JoshAshby/Robotbob/Doc/dox/latex/uart_8h.tex

\hypertarget{uart_8h}{
\section{/home/joshua/Desktop/Stuff/github/repos/Robotbob/uart.h File Reference}
\label{uart_8h}\index{/home/joshua/Desktop/Stuff/github/repos/Robotbob/uart.h@{/home/joshua/Desktop/Stuff/github/repos/Robotbob/uart.h}}
}
{\ttfamily \#include \char`\"{}global.h\char`\"{}}\par
\subsection*{Defines}
\begin{DoxyCompactItemize}
\item 
\#define \hyperlink{uart_8h_a62634036639f88eece6fbf226b45f84b}{BAUD}~9600
\item 
\#define \hyperlink{uart_8h_a6ac7d11a56af31a55035980e2fed464a}{BUFF\_\-LEN}~700
\item 
\#define \hyperlink{uart_8h_aa6b92cd101806fab27f766552beac344}{BAUD\_\-PRESCALE}~(((F\_\-CPU / (BAUD $\ast$ 16UL))) -\/ 1)
\end{DoxyCompactItemize}
\subsection*{Functions}
\begin{DoxyCompactItemize}
\item 
void \hyperlink{uart_8h_a57dec283060c68725e979681a6bda710}{uart\_\-start} (void)
\begin{DoxyCompactList}\small\item\em Sets up the registers and starts the UART for a baud of 9600. \item\end{DoxyCompactList}\item 
void \hyperlink{uart_8h_a3aa33581e04c3d77bf6baf4453699c60}{uart\_\-sendint} (uint8\_\-t data)
\begin{DoxyCompactList}\small\item\em Send an 8bit long piece of data. \item\end{DoxyCompactList}\item 
void \hyperlink{uart_8h_a5f6766b9959ff631558c8c6314c48551}{uart\_\-sendint16} (uint16\_\-t data)
\begin{DoxyCompactList}\small\item\em Send a 16bit long piece of data. \item\end{DoxyCompactList}\item 
void \hyperlink{uart_8h_a23796b5110daf59f60bf0e24073723e5}{uart\_\-sendchar} (char $\ast$data)
\begin{DoxyCompactList}\small\item\em Sends either a single piece of data stored as a char, or sends a string. (If sending a string, avr-\/gcc will yell a warning at you, you can ignore it). \item\end{DoxyCompactList}\item 
uint8\_\-t \hyperlink{uart_8h_a26112ddd1ecbbf65d98511a3434bc8d5}{uart\_\-get} (void)
\begin{DoxyCompactList}\small\item\em Returns the data which was stored in the recieve register and retreived by the interrupt. \item\end{DoxyCompactList}\end{DoxyCompactItemize}
\subsection*{Variables}
\begin{DoxyCompactItemize}
\item 
char \hyperlink{uart_8h_ab081191b17e7bd10a1479ae8aa05e879}{input\_\-buffer} \mbox{[}BUFF\_\-LEN\mbox{]}
\item 
uint16\_\-t \hyperlink{uart_8h_a15495a67f4607849736feca6c3f11b08}{read\_\-spot}
\end{DoxyCompactItemize}

\subsection{Define Documentation}
\hypertarget{uart_8h_a62634036639f88eece6fbf226b45f84b}{
\index{uart.h@{uart.h}!BAUD@{BAUD}}
\index{BAUD@{BAUD}!uart.h@{uart.h}}
\subsubsection[{BAUD}]{\setlength{\rightskip}{0pt plus 5cm}\#define BAUD~9600}}
\label{uart_8h_a62634036639f88eece6fbf226b45f84b}
\hypertarget{uart_8h_aa6b92cd101806fab27f766552beac344}{
\index{uart.h@{uart.h}!BAUD\_\-PRESCALE@{BAUD\_\-PRESCALE}}
\index{BAUD\_\-PRESCALE@{BAUD\_\-PRESCALE}!uart.h@{uart.h}}
\subsubsection[{BAUD\_\-PRESCALE}]{\setlength{\rightskip}{0pt plus 5cm}\#define BAUD\_\-PRESCALE~(((F\_\-CPU / (BAUD $\ast$ 16UL))) -\/ 1)}}
\label{uart_8h_aa6b92cd101806fab27f766552beac344}
\hypertarget{uart_8h_a6ac7d11a56af31a55035980e2fed464a}{
\index{uart.h@{uart.h}!BUFF\_\-LEN@{BUFF\_\-LEN}}
\index{BUFF\_\-LEN@{BUFF\_\-LEN}!uart.h@{uart.h}}
\subsubsection[{BUFF\_\-LEN}]{\setlength{\rightskip}{0pt plus 5cm}\#define BUFF\_\-LEN~700}}
\label{uart_8h_a6ac7d11a56af31a55035980e2fed464a}

\subsection{Function Documentation}
\hypertarget{uart_8h_a26112ddd1ecbbf65d98511a3434bc8d5}{
\index{uart.h@{uart.h}!uart\_\-get@{uart\_\-get}}
\index{uart\_\-get@{uart\_\-get}!uart.h@{uart.h}}
\subsubsection[{uart\_\-get}]{\setlength{\rightskip}{0pt plus 5cm}uint8\_\-t uart\_\-get (
\begin{DoxyParamCaption}
\item[{void}]{}
\end{DoxyParamCaption}
)}}
\label{uart_8h_a26112ddd1ecbbf65d98511a3434bc8d5}

Returns the data which was stored in the recieve register and retreived by the interrupt. 

\begin{DoxyParams}{Parameters}
\item[{\em void}]-\/ Takes nothing \end{DoxyParams}
\begin{DoxyReturn}{Returns}
uint8\_\-t -\/ The data in the form of an 8bit long piece of data 
\end{DoxyReturn}
\hypertarget{uart_8h_a23796b5110daf59f60bf0e24073723e5}{
\index{uart.h@{uart.h}!uart\_\-sendchar@{uart\_\-sendchar}}
\index{uart\_\-sendchar@{uart\_\-sendchar}!uart.h@{uart.h}}
\subsubsection[{uart\_\-sendchar}]{\setlength{\rightskip}{0pt plus 5cm}void uart\_\-sendchar (
\begin{DoxyParamCaption}
\item[{char $\ast$}]{ data}
\end{DoxyParamCaption}
)}}
\label{uart_8h_a23796b5110daf59f60bf0e24073723e5}

Sends either a single piece of data stored as a char, or sends a string. (If sending a string, avr-\/gcc will yell a warning at you, you can ignore it). 

\begin{DoxyParams}{Parameters}
\item[{\em data}]char$\ast$ -\/ The char data, or a string \end{DoxyParams}
\begin{DoxyReturn}{Returns}
void -\/ Returns nothing 
\end{DoxyReturn}
\hypertarget{uart_8h_a3aa33581e04c3d77bf6baf4453699c60}{
\index{uart.h@{uart.h}!uart\_\-sendint@{uart\_\-sendint}}
\index{uart\_\-sendint@{uart\_\-sendint}!uart.h@{uart.h}}
\subsubsection[{uart\_\-sendint}]{\setlength{\rightskip}{0pt plus 5cm}void uart\_\-sendint (
\begin{DoxyParamCaption}
\item[{uint8\_\-t}]{ data}
\end{DoxyParamCaption}
)}}
\label{uart_8h_a3aa33581e04c3d77bf6baf4453699c60}

Send an 8bit long piece of data. 

\begin{DoxyParams}{Parameters}
\item[{\em data}]uint8\_\-t -\/ The 8bit long data \end{DoxyParams}
\begin{DoxyReturn}{Returns}
void -\/ Returns nothing 
\end{DoxyReturn}
\hypertarget{uart_8h_a5f6766b9959ff631558c8c6314c48551}{
\index{uart.h@{uart.h}!uart\_\-sendint16@{uart\_\-sendint16}}
\index{uart\_\-sendint16@{uart\_\-sendint16}!uart.h@{uart.h}}
\subsubsection[{uart\_\-sendint16}]{\setlength{\rightskip}{0pt plus 5cm}void uart\_\-sendint16 (
\begin{DoxyParamCaption}
\item[{uint16\_\-t}]{ data}
\end{DoxyParamCaption}
)}}
\label{uart_8h_a5f6766b9959ff631558c8c6314c48551}

Send a 16bit long piece of data. 

\begin{DoxyParams}{Parameters}
\item[{\em data}]uint16\_\-t -\/ The 16bit long data \end{DoxyParams}
\begin{DoxyReturn}{Returns}
void -\/ Returns nothing 
\end{DoxyReturn}
\hypertarget{uart_8h_a57dec283060c68725e979681a6bda710}{
\index{uart.h@{uart.h}!uart\_\-start@{uart\_\-start}}
\index{uart\_\-start@{uart\_\-start}!uart.h@{uart.h}}
\subsubsection[{uart\_\-start}]{\setlength{\rightskip}{0pt plus 5cm}void uart\_\-start (
\begin{DoxyParamCaption}
\item[{void}]{}
\end{DoxyParamCaption}
)}}
\label{uart_8h_a57dec283060c68725e979681a6bda710}

Sets up the registers and starts the UART for a baud of 9600. 

\begin{DoxyParams}{Parameters}
\item[{\em void}]-\/ Takes nothing \end{DoxyParams}
\begin{DoxyReturn}{Returns}
void -\/ Returns nothing 
\end{DoxyReturn}

\subsection{Variable Documentation}
\hypertarget{uart_8h_ab081191b17e7bd10a1479ae8aa05e879}{
\index{uart.h@{uart.h}!input\_\-buffer@{input\_\-buffer}}
\index{input\_\-buffer@{input\_\-buffer}!uart.h@{uart.h}}
\subsubsection[{input\_\-buffer}]{\setlength{\rightskip}{0pt plus 5cm}char {\bf input\_\-buffer}\mbox{[}BUFF\_\-LEN\mbox{]}}}
\label{uart_8h_ab081191b17e7bd10a1479ae8aa05e879}
\hypertarget{uart_8h_a15495a67f4607849736feca6c3f11b08}{
\index{uart.h@{uart.h}!read\_\-spot@{read\_\-spot}}
\index{read\_\-spot@{read\_\-spot}!uart.h@{uart.h}}
\subsubsection[{read\_\-spot}]{\setlength{\rightskip}{0pt plus 5cm}uint16\_\-t {\bf read\_\-spot}}}
\label{uart_8h_a15495a67f4607849736feca6c3f11b08}
