JoshAshby/Robotbob/Doc/bob.pdf

http://bob.joshashby.com
In Conjunction with:

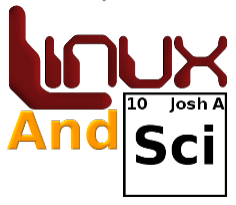
[picture p8: figure]

http://joshashby.com

# Project: Bouncing Off Bumpers

## Joshua Ashby Maurice Ashby Linux And Sci

http://joshashby.com
joshuaashby@joshashby.com

## November 12, 2010

Abstract

Bouncing off Bumpers, or BOB is a competition robot built by Joshua Ashby and his grandfather Maurice Ashby for the April 15th, 2009 Sparkfun Autonomous Vehicle Competition. It measures approximately 3 feet long by 2 feet wide by 2 feet tall; it weights approximately 50 pounds without the battery and electronics. This paper will go into detail about the many systems involved in the build process of BOB, and provide insight into how many of these systems were designed, and the logic behind them (Please note that this paper is always going to be changing, and the data could easily change the day after the latest pubilishing).
As of April 17th 2010, BOB has also competed in the 2010 Sparkfun AVC and won the Kill Switch award, however due to both a programming bug and hardware issue, he would not turn left and as a result was not able to get around the building, only 10%.

## Contents

1 Revisions | 5
2 Introduction and Background | 6
3 Platform | 6
3.1 Shape, Design and Material | | 6
3.2 Steering | | 6
3.3 Propulsion | | 6
4 Electronics | 8
4.1 Introduction | | 8
4.2 Motor controller | | 8
4.2.1 | Generation 1 | | 9
4.2.2 | Generation 2 | | 9
4.2.3 | Generation 3 | | 9
4.2.4 | Generation 4 | | 9
4.3 Power Node | | 9
5 Software | 10
5.1 Libraries - Introduction | 10
5.2 Digital Functions | 10
5.2.1 Example | 10
5.3 Analog Functions | 10
5.3.1 Example | 11
5.4 PWM Functions | 11
5.4.1 Example | 11
5.5 Robotics Functions | 11
5.5.1 Example | 12
5.6 Boot Functions | 12
5.6.1 | Example | 12
6 About the builders | 13
6.1 Joshua Ashby | 13
6.2 Maurice Ashby | 13
7 Appendix | 14

## List of Figures

1 | Example of the steering build used | | 7
2 | Example of the steering motor | | 7
3 | Example of the drive system used | | 8

## List of Files & Examples

1 | Digital examples | 10
2 | Analog examples | 11
3 | PWM examples | 11
4 | Robot examples | 12
5 | Boot examples | 12
6 | Adc.c | 14
7 | Pwm.c | 15
8 | Digital.c | 23
9 | Boot.c | 24
10 | Robot.c | 26
11 | Global.h | 28

12 | Version.h | 28
13 | Bob.tex | 29

## 1 Revisions

March 10th/11th/12th, 2010 - Joshua Ashby
Added more to the electronics, Motor controller node part to include the new Quad Low-side V1.5.1 through Revision 3 boards.
April 19th, 2010 - Joshua Ashby
Added even more to the new sections, cleaning it up, and overall re-writing some parts for better understanding. Rewrote software section also.
April 20th, 2010 - Joshua Ashby
Finished the software section and got the appendix of code cleaned up. also changed the program boxes from floats to listings. Still need to fix the steering descriptor section (marked with TODO).
November 11th, 2010 - Joshua Ashby
Started work on updating the various sections and the hardware section for the new boards and matching code. Up-dated Linux And Sci logo.

## 2 Introduction and Background

The electronics were designed by me (Joshua Ashby), and built by me along with the aid of my grandfather Maurice Ashby. As of March 10th, 2010 BOB is running on the newly designed and completed Generation 3 electronics. These electronics include the ”Taco” Quad-Motor Motor controller board with a few minor additions to the board, along with several other minor boards. Over all the design process for the electronics have taken the longest as the motor controllers must be able to meet the demand of 10A per motor, as a result several generation of electronics have gone out the window.
As of November 11th 2010, design on the Generation 4 electronics has been started. These boards are regressing to the multiple ”Nodes” consisting of the main brain node, or Master Node, two ”dead¹
” motor controller nodes.
The mechanics of the robot, which refers to the frame and body, the steering and related mechanisms, and the propulsion system were designed and built by us over a course of approximately 5 weeks, and has not had any major problems besides the replacement of the front motor.

## 3 Platform²

## 3.1 Shape, Design and Material

In order to build the frame in both a time and cost effective way, we choose to reuse some old square steel tubing that measures and has a wall thickness of. My grandfather had just enough laying around his shop to build a frame with. By using steel square tubing, and welding the joints, we were able to build a sturdy frame capable of carrying well over 100LBS over rough terrain.
The design of a three wheeled robot came after evaluating the cost of the wheels that would be used; to keep the cost down, only three wheels would be used. Because only three wheels would be used, the frame would have to be built in a fashion that did not promote tilting when the robot turns but still allow a large amount of room to build on top of. To accomplish this, an elongated pentagon design was created. The main drive wheel would be placed at the back of the robot in a triangle shaped portion of the frame, while the middle and front of the body would be a square shape, with two wheels in the front to steer with.

## 3.2 Steering

The steering for BOB was modeled after a car style steering system, where two wheels are connected via a rod which is in turn moved left or right to turn the wheels (Figure 1).
TODO: Fix this description
The build of this was accomplished by using two pre-built wheel casters, and welding on strips of quarter inch thick steel. These strips are approximately 6 inches long, and at the end that is not welded to the caster wheels, there is a hole drilled. Then connecting the two wheels via these strips, is a second pair of steel strips that are hooked up to the steering motor.
The steering motor is a 9.6V 10A drill motor that has been mounted with a right angle drive. This allows the motor to lay flat with the robot frame and still be able to turn the steering rod (Figure 2).
One problem that we did not foresee while building the steering, is the ability to drive straight. Because the steering mechanism does not have a method of straighting its self out quickly and effectivly, a new task is introduced to the electronics and programming until further improvments to the steering can be made. This may be accomplished by turning the front motor into an mechanism much like a servo through the use of programming and the ability of the motor controllers, however as of right now, thing has been done to take care of this problem.

## 3.3 Propulsion

Transferring power from the drill motor to the back drive wheel was one of the greatest technical difficulties we en-countered. We started off by testing the idea of a friction drive. This style of drive has the motor running parallel to the wheel, and the output shaft using friction to turn the wheel. This worked great going downhill, but as soon as the drive had a load to pull, such as on flat ground, or uphill, the drive would start to slip.

1Dead in this sense means these nodes do not have any programmable intellegence on them. They are useless without the Master Node. 2Please note, the frame was made to be cheap, and need little maintanince


Figure 1: Example of the steering build used


Figure 2: Example of the steering motor

Our second attempt was based off of a bike, just instead of a chain drive, we decided to do a belt drive as my grandfather had many of the needed parts. The motor was mounted perpendicular to the rotating axis of the wheel, and had a small 1.25 inch radius belt pulley on it. The wheel then had a larger, 2 inch radius, belt pulley on it. The two pulleys were connected via 8 inch diameter cogged belt. The axle for the motor is a milled axle that is supported by a bearing block at one end. The other end is tapered down to allow it to fit in the motor chuck. This also allows the motor to be disconnected from the axle, allowing the robot to be moved around with out power to the motor. (Figure 3).

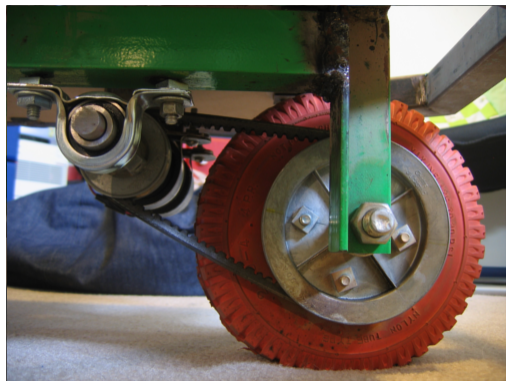
[picture p9: figure]

Figure 3: Example of the drive system used

This drive system worked perfectly both downhill and uphill, and as a result it is the drive system currently used. The motor is the same as the steering motor, a recycled drill motor that is rated at 9.6V and 10A.

## 4 Electronics

## 4.1 Introduction

The electronics have always been a troublesome matter for this project and as this is being typed, the electronics still are providing issues, even with new designs.
The motors, which each draw 10A, must have easy to use, and cheap to build motor controllers, along with the ability to easily replace major parts while the robot is not in the Lab or near a soldering iron. This means the motor controllers can not be store bought, as all of the quality controllers that we can find are not only expensive, but also do not have common, easy to find parts. Instead to replace a part, the whole controller must be replaced most the time³ .
Generation 1 electronics consisted of one micro-controller, and one and a half motor controllers. These electronics shorted out at the 2009 Sparkfun AVC competition, and as a result will only be used as both a comparison, and as a resource for what not to do on future generations.

## 4.2 Motor controller

As stated above, the use of store bought motor controllers is out of the question for use on BOB. They tend to be expensive, and typically must have the whole unit replaced if something burns out. Because of this, the motor controllers have been hand designed by us.

3Plus it’s funner to build your own controllers

### 4.2.1 Generation 1

The first version, which is the version that was used during the 2009 Sparkfun AVC competition, was designed to be very simple, and yet still provide the power that was needed for the motors. It consisted of a TIP125 PNP transistor driving a pair of paralleled IRF540N n-channel MOSFETs. At the time of their designing and building, we both were very new to MOSFETs and as a result the knowledge of how to hook the MOSFETs up, and the voltage required to drive them was unknown. This caused many problems, such as the MOSFETs not having enough voltage and amperes for them to fully close. This caused them to over heat, and also caused a massive power spike somewhere along the lines that burnt out the MOSFETs and transistor.

### 4.2.2 Generation 2

The new generation 2 motor controllers were designed to avoid these problems, along with begin to merge into a modular system. These new motor controllers were called the Motor Nodes, and included two motor controllers, and a micro-controller that talked to the controllers. The micro-controller for generation 2 electronics was an Atmega328p which took care of both the sensors and the motor controllers. The basic design of using the transistors to switch the logic level were used, but with a few improvments such as temperature shut off for the MOSFETs, however it was discovered in late December 2009 that this method of driving the MOSFETs was not atiquate enough, and as a result this method is no longer used. For this reason the Generation 2 electronics have been ditched and new Generation 3 electronics designed and put in place.

### 4.2.3 Generation 3

The Generation 3 board consists of the main ATmega328P running at 5V with a 16MHz crystal. The I2C headers are broken out⁴
, and the ATmega has 2 LEDs connected to PortD pins 3 and 5, also known as OC2B and OC0B. This allows for PWM debugging of any functions. Next the Atmega is connected to two TC4424CPA chips, one of these chips being on PD1 and PD2, OR1A, OR1B for PWM speed control, and the other chip being on pins PD2, PD4 for simple digital triggering of relays.
This board, which is named Taco is infact a general purpose MOSFET board, but has been desinged in conjunction with BOB for use on him, however the only problem so far has been the traces not being big enough to carry the 10A and 20A from the motors. As a result the board also has several high amperage wires for the MOSFETs and motor outputs.
The I2C header is broken out which I2C on the Atmega328p is the analog pins 4 and 5, which means that the board can also be used for analog inputs, such as was used for the ultrasounds on BOB.

### 4.2.4 Generation 4

The Current and newest Generation 4 boards regresses back to the node building system, in preparation for a full I2C network system in Generation 5 boards. This means the power, and the Atmega328p and support hardware are all on one board, with currently a 10 pin ribbon cable system running to each of the two motor controller nodes. These cables simply carry PWM and digital signals to the motor controller boards for now.

Each motor controller board is the same design since they both serve similar motors. As a result they have the MOSFETs for the motor and it’s corisponding dirrection relay. Future versions may bring in the temperature shut off for the MOSFETs however this feature is currently not going to be on the Generation 4 boards for technical reasons. Along with the new MOSFET drivers that were introduced in Generation 3 electronics, the MOSFET gates have current limiting resistors, and 12V zener diodes to prevent power spikes. The boards also have a 10uF and 1000uF capacitor to help smooth out power drops from the motors.

## 4.3 Power Node

The Power Node, as of Generation 2 electronics is simply a dead Node as one might call it. It has no intelligence, instead it’s only function for generation 2 is to regulate and distribute 5V to all the boards. It does this via Molex

4Which also provide two analog pins for the ultrasounds on BOB connectors off of old ATX power supplies from computers. This same board design was used in the Generation 3 electronics also.
In Generation 4 electronics, the Power Node is intergrated with the Master Node for ease of use and space reasons.

## 5 Software

## 5.1 Libraries - Introduction

As of January 2010, BOB runs a custom writen library set that takes care of everything from PWM and digital function to analog, ultrasounds, and calibration. Newer additions to this library include (or will soon include) I2C functionality.⁵

## 5.2 Digital Functions

First up is the digital function library (Page: 23). The digital function library takes care of turning a pin on or off, which seems simple enough. While this task is quite trivial in code, those few extra lines tend to make the code look messy, which I don’t like as much.

void portB_out(int pin, int value)

Simply send the pin number (0 through 7), and the value (1 or 0) and the corrisponding pin on PORTB will be set to that value.

void portD_out(int pin, int value)

Simply send the pin number (0 through 7), and the value (1 or 0) and the corrisponding pin on PORTD will be set to that value.

void out(char port, int pin, int value)

Send the port letter, the pin number, and the value (0 or 1) and the corrisponding pin on that port will be set to that value.

### 5.2.1 Example

Listing 1: Digital examples

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

## 5.3 Analog Functions

| Unlike the digital code, reading from an analog pin takes some work. First you have to setup the registers, which in
| my case get me going at a prescaler of 128, interupt driven, and left alinged bits. The left aligned results mean that
| I don’t have to do fancy code and get 10bit results, which I don’t need. instead I can simply read the ADCH register
| and get an 8 bit result. The next step is to read the results, or change the pin that I am reading from, both which take
| more code. As a result of all this, placing the analog functions inside of a nice, clean library makes sense (Page: ??).

void adc_start(void)

Calling this will simply setup the correct registers, and start an interupt driven ADC comversion. After this is called
the value of the ADC can be found in the ADCH register.

5Please note that memory was not an issue during the time of the writing of these libraries there for they have many places that memory types can be changed to improve file size.

void adc_stop()

Simply stops the ADC conversions.

void adc_change(int chan)

Calling this with pins numbers 0-8 will cause the ADC to be stoped, the pin changed, and the ADC started again.

### 5.3.1 Example

Listing 2: Analog examples

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

## 5.4 PWM Functions

| Like the analog functions, the PWM functions that I needed were large, and very messy pieces of code. They consisted
| of several functions that setup the registers for the three PWM timers, and then several more to add in functions like
| ramp up and down functionability. (Page: 15).
| (#L)
| stands for number and letter respectivly, when used likst this it means too replace
| (#L)
| with something such as 0A or 2B.
| void pwm_setup_all(void)
| sets up the registers for all the PWM timers in phase correct not prescaled PWM mode.
| void pwm_setup(#)(void)
| Sets up the given PWM channel timer with the corrent register settings.
| void pwm(#L)(unsigned int value)
| Tests the turning motor and functions, simply goes through and cycles which direction every time. Sets the PWM
| duty cycle of the given channel.
| void pwm_ramp(#L)(unsigned int value, unsigned int speed)
| Ramps the given PWM channel at the given speed to the given duty cycle.
| void pwm_rampUp(#L)(unsigned int value, unsigned int speed)
| Ramps up the given PWM channel at the given speed to the given duty cycle.
| void pwm_rampDown(#L)(unsigned int value, unsigned int speed)
| Ramps down the given PWM channel at the given speed to the given duty cycle.

### 5.4.1 Example

Listing 3: PWM examples

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

## 5.5 Robotics Functions

| The robotics library takes care of most of the things that BOB needs to run. It houses the turn functions, and the filter
| that takes care of the ultrasound data. This filter is a custom rolling average with a few additions which smooth the
| data points out really well as the analog outputs on the ultrasounds are a little jumpy (Page: ??).

void turn_left(void)

Does exactly what it says, simply takes care of the timing and everything for turning.

void turn_right(void)

Same as turn left.

void stop(void)

Stops everything and displays the error 1.

void calibrate(void)

Calling this starts the ADC, then fills the rolling average, setting the base length to the first set of data from when the bots not moving, very useful and when used with the filter makes nice data for BOB.

void ultrasound_test(void)

Tests the ultrasounds and displays the results with the on board LEDs

int ultrasound_filter(int pin)

Starts a rolling average with a few additions to smooth out data points, returns the current average.

void test_turn(void)

Tests the turning motor and functions, simply goes through and cycles which direction every time.

void test_motor(void)

Tests the main propulsion motor and functions, simply goes through and cycles which direction every time.

### 5.5.1 Example

Listing 4: Robot examples

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

## 5.6 Boot Functions

| Finally the boot library takes care of setting everything up as the robot first starts, basically it’s an implementation of
| a low level bios for BOB (Page: 24).

void bios(void)

Calling this will setup everything that BOB needs to run, calibrates the sensors and in general gets everything ready.

void all_good(void)

Status LED on.

void oh_crap(void)

Status LED off.

void error(int type)

gives a few different types of errors that can be given through the LEDs, not really used all the much yet.

### 5.6.1 Example

Listing 5: Boot examples

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

## 6 About the builders

## 6.1 Joshua Ashby

## 6.2 Maurice Ashby

## 7 Appendix

All code and schematics are released under the Creative Commons Attribution-Noncommercial 3.0 United States License.
The code can be found online at github: http://github.com/JoshAshby/Robotbob/tree/experimental
Source for this LaTeX PDF can be found online at github: http://github.com/JoshAshby/BOB-Documentation

Listing 6: Adc.c

1 | / /−−−−−−−−−−−−−−−−−−−−−−−−−−−−−−−−−−−−−−−−−−−
2 | / *
3 | ADC . c
4 | 2010 − J o s h Ashby
5 | j o s h u a a s h b y@j o s h a s h b y . com
6 | h t t p : / / j o s h a s h b y . com
7 | h t t p : / / g i t h u b . com / J o s hA s h b y
8 | f r e e n o d e / # l i n u x a n d s c i − J o s hA s h b y
9 | * /
10 | / /−−−−−−−−−−−−−−−−−−−−−−−−−−−−−−−−−−−−−−−−−−−
11 | # i n cl u d e ” a dc . h ”
12 | # i n cl u d e ”pwm . h ”
13 | # i n cl u d e ” d i g i t a l . h ”
14 | # i n cl u d e ” b o ot . h ”
15 | # i n cl u d e ” g l o b a l . h ”
16 | # i n cl u d e ” r o b o t f u n c . h ”
17 | ISR ( ADC vect )
18 | {
19 | }
20 | v oi d a d c s t a r t ( v oi d )
21 | {
22 | ADCSRA |= ( 1 << ADPS2 )
23 | | ( 1 << ADPS1 )
24 | | ( 1 << ADPS0 ) ; / / S e t ADC p r e s c a l e r t o 128 − 125KHz s am ple r a t e
@ 16MHz
25 | ADMUX |= ( 1 << REFS0 ) ; / / S e t ADC r e f e r e n c e t o AVCC
26 | ADMUX |= ( 1 << ADLAR) ; / / L e f t a d j u s t ADC r e s u l t t o all ow e a s y 8 b i t
r e a di n g
27 | ADCSRA |= ( 1 << ADATE) ;
28 | ADCSRA |= ( 1 << ADEN) ; | / / E n a ble ADC
29 | ADCSRA |= ( 1 << ADIE ) ; | / / E n a ble ADC I n t e r r u p t
30 | s e i ( ) ;
31 | ADCSRA |= ( 1 << ADSC) ; | / / S t a r t A2D C o n v e r si o n s
32 | }
33 | v oi d a d c s t o p ( ) {
34 | / / s t o p t h e ADC
35 | ADCSRA &= ˜ ( 1 << ADSC) ;
36 | }
37 | v oi d a d c c h a n g e ( i n t c ha n ) {
38 | / / s t o p t h e ADC
39 | ADCSRA &= ˜ ( 1 << ADSC) ;
40 | / / and now c h a n ge t h e ADMUX b i t s t o f i t w hic h c h a n n al you want t o use ,
t h i s s h o ul d p r o b a bl y be r e p l a c e d by a s w i t c h s o o n
41 | s wi t c h ( c ha n ) {
42 | c a s e 0 :
43 | ADMUX &= ˜ ( 1 << MUX0)
44 | & | ˜ ( 1 << MUX1)
45 | & | ˜ ( 1 << MUX2)
46 | & | ˜ ( 1 << MUX3) ;

47 | break ;
48 | c a s e 1 :
49 | ADMUX |= | ( 1 << MUX0) ;
50 | ADMUX &= ˜ ( 1 << MUX1)
51 | & | ˜ ( 1 << MUX2)
52 | & | ˜ ( 1 << MUX3) ;
53 | break ;
54 | c a s e 2 :
55 | ADMUX &= ˜ ( 1 << MUX0) ;
56 | ADMUX |= | ( 1 << MUX1) ;
57 | ADMUX &= ˜ ( 1 << MUX2)
58 | & | ˜ ( 1 << MUX3) ;
59 | break ;
60 | c a s e 3 :
61 | ADMUX |= | ( 1 << MUX0)
62 | | | ( 1 << MUX1) ;
63 | ADMUX &= ˜ ( 1 << MUX2)
64 | & | ˜ ( 1 << MUX3) ;
65 | break ;
66 | c a s e 4 :
67 | ADMUX &= ˜ ( 1 << MUX0)
68 | & | ˜ ( 1 << MUX1) ;
69 | ADMUX |= | ( 1 << MUX2) ;
70 | ADMUX &= ˜ ( 1 << MUX3) ;
71 | break ;
72 | c a s e 5 :
73 | ADMUX |= | ( 1 << MUX0) ;
74 | ADMUX &= ˜ ( 1 << MUX1) ;
75 | ADMUX |= | ( 1 << MUX2) ;
76 | ADMUX &= ˜ ( 1 << MUX3) ;
77 | break ;
78 | c a s e 6 :
79 | ADMUX &= ˜ ( 1 << MUX0) ;
80 | ADMUX |= | ( 1 << MUX1)
81 | | | ( 1 << MUX2) ;
82 | ADMUX &= ˜ ( 1 << MUX3) ;
83 | break ;
84 | c a s e 7 :
85 | ADMUX |= | ( 1 << MUX0)
86 | | | ( 1 << MUX1)
87 | | | ( 1 << MUX2) ;
88 | ADMUX &= ˜ ( 1 << MUX3) ;
89 | break ;
90 | c a s e 8 :
91 | ADMUX &= ˜ ( 1 << MUX0)
92 | & | ˜ ( 1 << MUX1)
93 | & | ˜ ( 1 << MUX2) ;
94 | ADMUX |= | ( 1 << MUX3) ;
95 | break ;
96 | }
97 | ADCSRA |= ( 1 << ADSC) ;
98 | }

Listing 7: Pwm.c

1 | / /−−−−−−−−−−−−−−−−−−−−−−−−−−−−−−−−−−−−−−−−−−−
2 | / *
3 | PWM. c

4 | 2010 − J o s h Ashby
5 | j o s h u a a s h b y@j o s h a s h b y . com
6 | h t t p : / / j o s h a s h b y . com
7 | h t t p : / / g i t h u b . com / J o s hA s h b y
8 | f r e e n o d e / # l i n u x a n d s c i − J o s hA s h b y
9 | * /
10 | / /−−−−−−−−−−−−−−−−−−−−−−−−−−−−−−−−−−−−−−−−−−−
11 | # i n cl u d e ” a dc . h ”
12 | # i n cl u d e ”pwm . h ”
13 | # i n cl u d e ” d i g i t a l . h ”
14 | # i n cl u d e ” b o ot . h ”
15 | # i n cl u d e ” g l o b a l . h ”
16 | # i n cl u d e ” r o b o t f u n c . h ”
17 | v oi d p w m s e t u p a l l ( v oi d ) {
18 | TCCR0B |= (1<<CS00 )
19 | | (1<<CS01 ) ;
20 | TCCR0A |= (1<<WGM00) ;
21
22 | DDRD |= (1<<5) ;
23 | DDRD |= (1<<6) ;
24
25 | pwm speed0A = 0 ;
26 | pwm value0A = 0 ;
27 | pwm val ue ol d 0A = 0 ;
28
29 | pwm speed0B = 0 ;
30 | pwm value0B = 0 ;
31 | pwm val ue ol d 0B = 0 ;
32
33 | TCCR1B |= (1<<CS11 )
34 | | (1<<CS10 ) ;
35 | TCCR1A |= (1<<WGM10) ;
36
37 | DDRB |= (1<<1) ;
38 | DDRB |= (1<<2) ;
39
40 | pwm speed1A = 0 ;
41 | pwm value1A = 0 ;
42 | pwm val ue ol d 1A = 0 ;
43
44 | pwm speed1B = 0 ;
45 | pwm value1B = 0 ;
46 | pwm val ue ol d 1B = 0 ;
47
48 | TCCR2B |= (1<<CS22 ) ;
49 | TCCR2A |= (1<<WGM20) ;
50
51 | DDRD |= (1<<3) ;
52 | DDRB |= (1<<3) ;
53
54 | pwm speed2A = 0 ;
55 | pwm value2A = 0 ;
56 | pwm val ue ol d 2A = 0 ;
57
58 | pwm speed2B = 0 ;
59 | pwm value2B = 0 ;
60 | pwm val ue ol d 2B = 0 ;
61 | }
62 | v oi d pwm setup0 ( v oi d )

{
TCCR0B |= (1<<CS00 )
| (1<<CS01 ) ;
TCCR0A |= (1<<WGM00) ;

DDRD |= (1<<5) ;
DDRD |= (1<<6) ;

pwm speed0A = 0 ;
pwm value0A = 0 ;
pwm val ue ol d 0A = 0 ;

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

/ /−−−−−−−−−−−−−−−−−−−−−−−−−−−−−−−−−−−−−−−−−−−
v oi d pwm setup1 ( v oi d )
{
TCCR1B |= (1<<CS11 )
| (1<<CS10 ) ;
TCCR1A |= (1<<WGM10) ;

DDRB |= (1<<1) ;
DDRB |= (1<<2) ;

pwm speed1A = 0 ;
pwm value1A = 0 ;
pwm val ue ol d 1A = 0 ;

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

DDRD |= (1<<3) ;
DDRB |= (1<<3) ;

pwm speed2A = 0 ;
pwm value2A = 0 ;
pwm val ue ol d 2A = 0 ;

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

Listing 8: Digital.c

/ /−−−−−−−−−−−−−−−−−−−−−−−−−−−−−−−−−−−−−−−−−−− / *
DIGITAL . h

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

# i n cl u d e ” d i g i t a l . h ”

# i n cl u d e ” b o ot . h ”

# i n cl u d e ” g l o b a l . h ”

# i n cl u d e ” r o b o t f u n c . h ”

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

Listing 9: Boot.c

# i n cl u d e ” a dc . h ”

# i n cl u d e ”pwm . h ”

# i n cl u d e ” d i g i t a l . h ”

# i n cl u d e ” b o ot . h ”

# i n cl u d e ” g l o b a l . h ”

# i n cl u d e ” r o b o t f u n c . h ”

# i n cl u d e <u t i l / d e l a y . h>

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

55 | }
| Listing 10: Robot.c
1 | # i n cl u d e ” a dc . h ”
2 | # i n cl u d e ”pwm . h ”
3 | # i n cl u d e ” d i g i t a l . h ”
4 | # i n cl u d e ” b o ot . h ”
5 | # i n cl u d e ” g l o b a l . h ”
6 | # i n cl u d e ” r o b o t f u n c . h ”
7 | # i n cl u d e <u t i l / d e l a y . h>
8 | / /−−−−−−−−−−−−−−−−−−−−−−−−−−−−−−−−−−−−−−−−−−−
9 | / *
10 | r o b o t f u n c . c
11 | 2010 − J o s h Ashby
12 | j o s h u a a s h b y@j o s h a s h b y . com
13 | h t t p : / / j o s h a s h b y . com
14 | h t t p : / / g i t h u b . com / J o s hA s h b y
15 | f r e e n o d e / # l i n u x a n d s c i − J o s hA s h b y
16 | * /
17 | / /−−−−−−−−−−−−−−−−−−−−−−−−−−−−−−−−−−−−−−−−−−−
18
19 | v oi d t u r n l e f t ( v oi d ) {
20 | o ut ( 'D ' , T r el a y , 1 ) ;
21 | d el a y m s ( 5 ) ;
22 | pwm1B ( 2 5 5 ) ;
23 | d el a y m s ( 2 0 0 ) ;
24 | pwm1B ( 0 ) ;
25 | o ut ( 'D ' , T r el a y , 0 ) ;
26 | }
27 | v oi d t u r n r i g h t ( v oi d ) {
28 | pwm1B ( 2 5 5 ) ;
29 | d el a y m s ( 1 5 0 ) ;
30 | pwm1B ( 0 ) ;
31 | }
32 | v oi d s t o p ( v oi d ) {
33 | pwm0A ( 0 ) ;
34 | pwm0B ( 0 ) ;
35 | pwm1A ( 0 ) ;
36 | pwm1B ( 0 ) ;
37 | pwm2A ( 0 ) ;
38 | pwm2B ( 0 ) ;
39 | o ut ( 'D ' , 2 , 1 ) ;
40 | e r r o r ( 1 ) ;
41 | o ut ( 'D ' , T r el a y , 0 ) ;
42 | o ut ( 'D ' , D rela y , 0 ) ;
43 | }
44 | v oi d c a l i b r a t e ( v oi d ) {
45 | a d c c h a n g e ( 5 ) ;
46 | d el a y m s ( 2 0 ) ;
47 | a dc = ADCH;
48 | f o r ( j = 0 ; j <= 2 0; j ++ ) {
49 | i f (ADCH > a v e r a g e + 1 0 0 )
50 | {
51 | a dc = (ADCH/ 2 ) + ( a v e r a g e / 2 ) ;
52 | }
53 | i f (ADCH < a v e r a g e − 1 0 0 ) {
54 | a dc = (ADCH/ 2 ) + ( a v e r a g e / 2 ) ;

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

112 | v oi d t e s t m o t o r ( v oi d ) {
113 | pwm ramp1A ( 2 5 5 , 1 0 ) ;
114 | d el a y m s ( 2 0 0 0 ) ;
115 | pwm ramp1A ( 1 , 0 ) ;
116 | pwm1A ( 0 ) ;
117 | d el a y m s ( 5 0 0 ) ;
118 | o ut ( 'D ' , D rela y , 1 ) ;
119 | d el a y m s ( 5 0 0 ) ;
120 | pwm ramp1A ( 2 5 5 , 1 0 ) ;
121 | d el a y m s ( 2 0 0 0 ) ;
122 | pwm ramp1A ( 1 , 0 ) ;
123 | pwm1A ( 0 ) ;
124 | d el a y m s ( 5 0 0 ) ;
125 | o ut ( 'D ' , D rela y , 0 ) ;
126 | }

Listing 11: Global.h

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

Listing 12: Version.h

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

Listing 13: Bob.tex

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

245
246 \ end { document }
