JoshAshby/Robotbob/Doc/dox/latex/boot_8c.tex

\hypertarget{boot_8c}{
\section{/home/joshua/Desktop/Stuff/github/repos/Robotbob/boot.c File Reference}
\label{boot_8c}\index{/home/joshua/Desktop/Stuff/github/repos/Robotbob/boot.c@{/home/joshua/Desktop/Stuff/github/repos/Robotbob/boot.c}}
}
{\ttfamily \#include \char`\"{}global.h\char`\"{}}\par
\subsection*{Functions}
\begin{DoxyCompactItemize}
\item 
void \hyperlink{boot_8c_afd244851e03f78bc2eacb73200fb73a0}{bios} (void)
\begin{DoxyCompactList}\small\item\em Takes care of setting everything up, including LEDs and setting up pins for Outputs. \item\end{DoxyCompactList}\end{DoxyCompactItemize}

\subsection{Function Documentation}
\hypertarget{boot_8c_afd244851e03f78bc2eacb73200fb73a0}{
\index{boot.c@{boot.c}!bios@{bios}}
\index{bios@{bios}!boot.c@{boot.c}}
\subsubsection[{bios}]{\setlength{\rightskip}{0pt plus 5cm}void bios (
\begin{DoxyParamCaption}
\item[{void}]{}
\end{DoxyParamCaption}
)}}
\label{boot_8c_afd244851e03f78bc2eacb73200fb73a0}

Takes care of setting everything up, including LEDs and setting up pins for Outputs. 

\begin{DoxyParams}{Parameters}
\item[{\em void}]-\/ Takes nothing \end{DoxyParams}
\begin{DoxyReturn}{Returns}
void -\/ Returns nothing 
\end{DoxyReturn}
