JoshAshby/Robotbob/Doc/dox/latex/boot_8h.tex

\hypertarget{boot_8h}{
\section{/home/joshua/Desktop/Stuff/github/repos/Robotbob/boot.h File Reference}
\label{boot_8h}\index{/home/joshua/Desktop/Stuff/github/repos/Robotbob/boot.h@{/home/joshua/Desktop/Stuff/github/repos/Robotbob/boot.h}}
}
{\ttfamily \#include \char`\"{}global.h\char`\"{}}\par
\subsection*{Functions}
\begin{DoxyCompactItemize}
\item 
void \hyperlink{boot_8h_a439eacd87142e8821028cdec0ae3a057}{error} (char type)
\item 
void \hyperlink{boot_8h_afd244851e03f78bc2eacb73200fb73a0}{bios} (void)
\begin{DoxyCompactList}\small\item\em Takes care of setting everything up, including LEDs and setting up pins for Outputs. \item\end{DoxyCompactList}\end{DoxyCompactItemize}

\subsection{Function Documentation}
\hypertarget{boot_8h_afd244851e03f78bc2eacb73200fb73a0}{
\index{boot.h@{boot.h}!bios@{bios}}
\index{bios@{bios}!boot.h@{boot.h}}
\subsubsection[{bios}]{\setlength{\rightskip}{0pt plus 5cm}void bios (
\begin{DoxyParamCaption}
\item[{void}]{}
\end{DoxyParamCaption}
)}}
\label{boot_8h_afd244851e03f78bc2eacb73200fb73a0}

Takes care of setting everything up, including LEDs and setting up pins for Outputs. 

\begin{DoxyParams}{Parameters}
\item[{\em void}]-\/ Takes nothing \end{DoxyParams}
\begin{DoxyReturn}{Returns}
void -\/ Returns nothing 
\end{DoxyReturn}
\hypertarget{boot_8h_a439eacd87142e8821028cdec0ae3a057}{
\index{boot.h@{boot.h}!error@{error}}
\index{error@{error}!boot.h@{boot.h}}
\subsubsection[{error}]{\setlength{\rightskip}{0pt plus 5cm}void error (
\begin{DoxyParamCaption}
\item[{char}]{ type}
\end{DoxyParamCaption}
)}}
\label{boot_8h_a439eacd87142e8821028cdec0ae3a057}
