JoshAshby/Robotbob/Doc/dox/latex/main_8c.tex

\hypertarget{main_8c}{
\section{/home/joshua/Desktop/Stuff/github/repos/Robotbob/main.c File Reference}
\label{main_8c}\index{/home/joshua/Desktop/Stuff/github/repos/Robotbob/main.c@{/home/joshua/Desktop/Stuff/github/repos/Robotbob/main.c}}
}
{\ttfamily \#include \char`\"{}global.h\char`\"{}}\par
\subsection*{Functions}
\begin{DoxyCompactItemize}
\item 
int \hyperlink{main_8c_a840291bc02cba5474a4cb46a9b9566fe}{main} (void)
\end{DoxyCompactItemize}

\subsection{Function Documentation}
\hypertarget{main_8c_a840291bc02cba5474a4cb46a9b9566fe}{
\index{main.c@{main.c}!main@{main}}
\index{main@{main}!main.c@{main.c}}
\subsubsection[{main}]{\setlength{\rightskip}{0pt plus 5cm}int main (
\begin{DoxyParamCaption}
\item[{void}]{}
\end{DoxyParamCaption}
)}}
\label{main_8c_a840291bc02cba5474a4cb46a9b9566fe}
