JoshAshby/Robotbob/Doc/bob.jpg

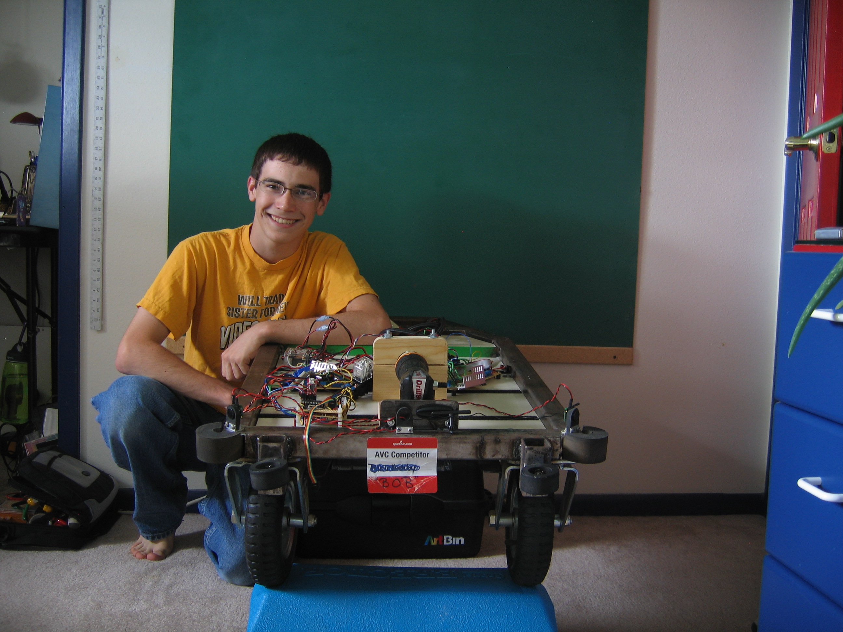
Doc/bob.jpg
