JoshAshby/Robotbob/Doc/photogate.png

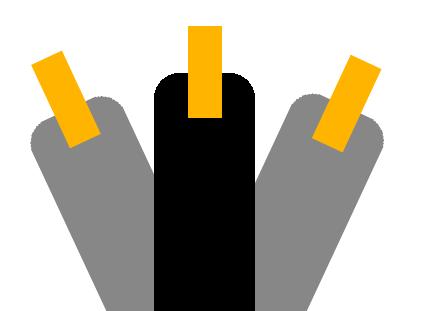
Doc/photogate.png
