JoshAshby/Robotbob/Hardware/Gen_4_main/BOB-4main-schem.png

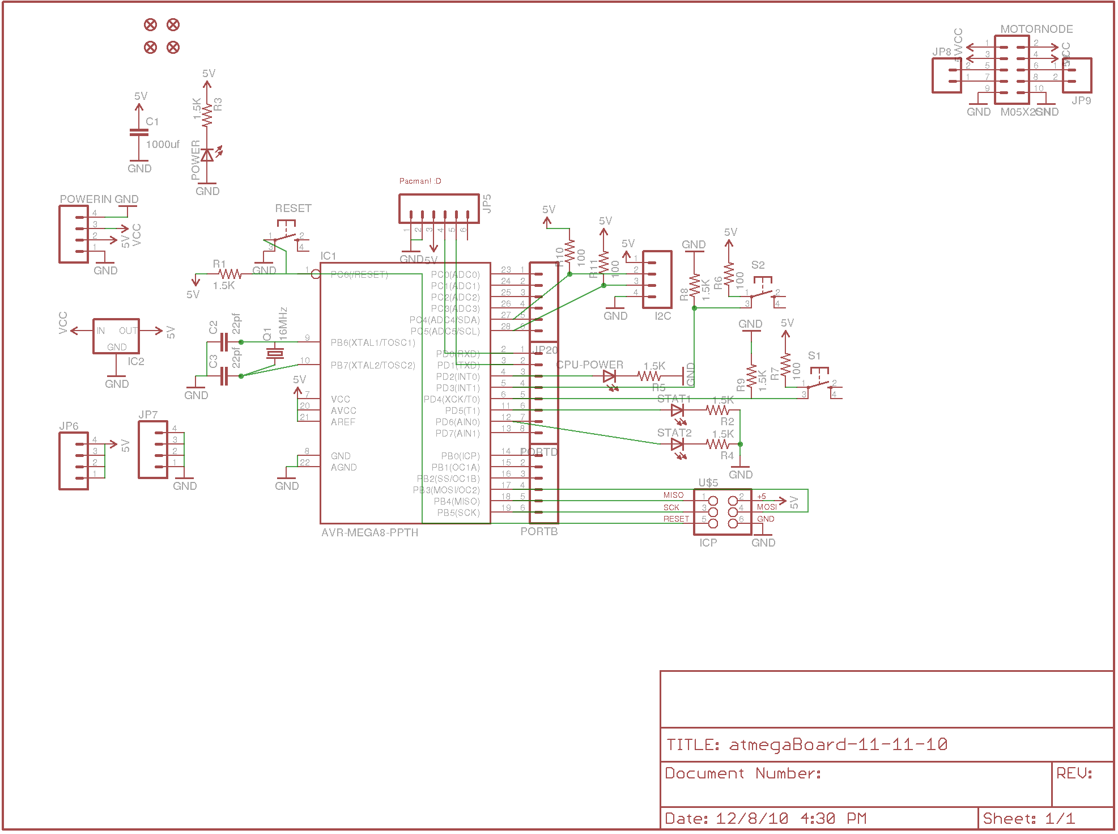
Hardware/Gen_4_main/BOB-4main-schem.png
