JoshAshby/Robotbob/Hardware/Gen_4_main/BOB-4main-top.png

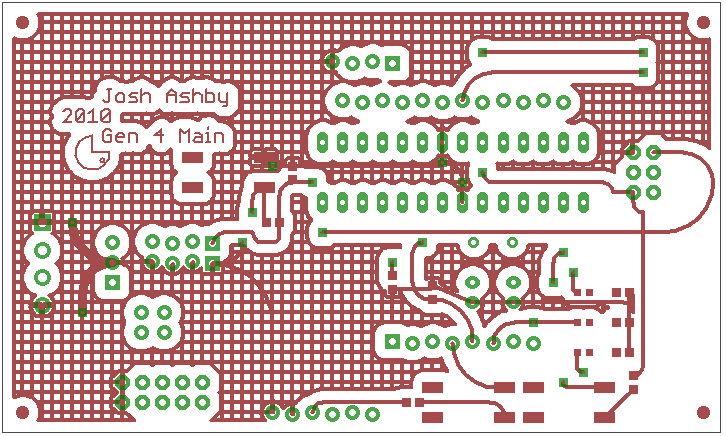
Hardware/Gen_4_main/BOB-4main-top.png
