JoshAshby/Robotbob/Hardware/Gen_4_main/BOB-4main.png

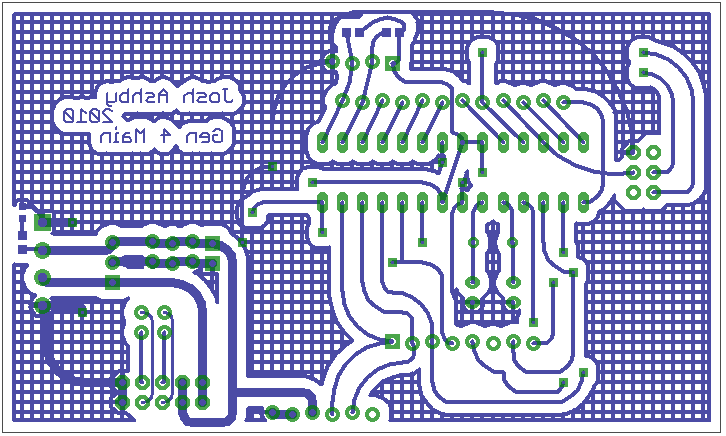
Hardware/Gen_4_main/BOB-4main.png
