JoshAshby/Robotbob/(commit log)

2009-06-16 Updated the arduino code for the newest control board
2009-07-09 replaced code with a more basic version that i will build off of, with luck this will get BOBs newly finished motor controllers working and driving from tele-op.
2009-07-09 updated his code, it has been replaced by a better cleaner version that will hopefully get BOBs new motor controllers working
2009-07-09 made sure everything worked and added the left out digitalwrite's, should work for forward speed and relay switching
2009-07-09 Finally got his code working, current version is a simple tele-op code, i'll add AI and sensors later
2009-08-07 wrote a library for the arduino side, it should take care of the motor drive for my setup
2009-12-05 12-4-09 .::. Josh Ashby .::. added i2c support for the robot drive library, also added a function for generation 3 electronics to get the i2c address according to different header pin configurations
2010-02-13 new branch with new C code, removed/got rid of arduino libs
2010-02-14 changed a bunch of stuff for the pwm, and cleaned everything up into nice files...somewhat
2010-02-14 added speed back in to the pwm
2010-02-15 added pwm_ramp which will auto detect which way to ramp the pwm duty cycle
2010-03-12 Added functions for PWM on ORC1B as well as ORC1A, and started work on a boot time script, bios kind of deal
2010-03-17 Added a basic bios, or the start of one. also started work on a robot library for BOB, and worked a few bugs out of the PWM code. also added ADC channel choosing
    [adc.c, boot.c, boot.h, digital.c, main.c, pwm.c, pwm.h, robotfunc.c]
2010-03-18 added a test feature, and made sure the ADC switching code worked. need to clean it up into a nice switch from the many if then
2010-03-19 finished the pwm library, just have to clean everything up, and get the AI logic writen into robotfunc.c
2010-03-20 added single function to take care of output on ports D and B along with the base of a filter for the ultrasounds
2010-03-22 had a few minor revisions to the code before this push, but didn't have internet, and forgot to commit them. got the ADC code to finally work, and the filter works well, starting to work on the logic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
    [adc.c, boot.c, digital.h, global.h, main.c, pwm.c, robotfunc.c, robotfunc.h]
2010-03-22 cleaned up the startup all into the bios (aka boot:setup) and added a new error, now two error types. also started on the turning functions for the AI]
    [boot.c, boot.h, main.c, robotfunc.c]
2010-03-22 fixed the bios (calibrating ADC before ADC got started) and added a ultrasound_test function
    [adc.c, boot.c, boot.h, global.h, main.c, pwm.h, robotfunc.c, robotfunc.h]
2010-03-22 fixed problem of i overflowing in pwm.c and added a new error, type 2
    [boot.c, main.c, pwm.c, robotfunc.c]
2010-03-23 fixed the dirrection commands in turn_left and turn_right in robotfunc.c/h
    [global.h, main.c, robotfunc.c, robotfunc.h]
2010-03-26 added two more features that test his steering and his back motor, and cleaned a little bit of the code up again. still have that problem of i overflowing in pwm_ramp in pwm.c
    [global.h, main.c, robotfunc.c, robotfunc.h]
2010-03-26 changed the unsigned int in pwm_ramp1A to a regular int to see if i overflowing has anything to do with it
2010-04-17 added turn functions for the AVC 2010 also removed the can turn, and the turn validation functions as they proved to be too much of a problem.
    [main.c, robotfunc.c, robotfunc.h]
2010-11-11 Started work on his code again, adding in a few variables and getting it cleaned and ready for the new boards I'm in the process of designing for him.
2010-12-08 added board pictures of new gen 4 main board, getting ready for merge of libraries from Dev-board repo
2010-12-08 added schematic and logo, along with eagle files for the main board
    [atmegaBoard-11-11-10.brd, atmegaBoard-11-11-10.sch]
2010-12-10 Started branch, removed old files, kept BOB specific ones, changed those up quite a bit and made them match my current coding style. new files ported from dev-board repo. Complete libraries now avail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
2010-12-10 compat between new and old code working so far, time to get rewriting the ultrasound filters possibly, and the pwm ramp functions. may remove pwm0 and pwm2 since timer0 and soon to be timer2 are take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
2010-12-11 attempting to get the button code to only send a uart command once, not working so well and likes to send 06 over and over again, along with a few other values
    [boot.c, digital.c, main.c, uart.c]
